AutomatedOlfactoryBehaviour/BEAST/README.md

# BEAST
Supporting material for the manuscript on "High-throughput automated olfactory phenotyping of group-housed mice"
