AutomatedOlfactoryBehaviour/BEAST/Circuit Diagrams/Gear Pump Controller/GearPump2.PDF

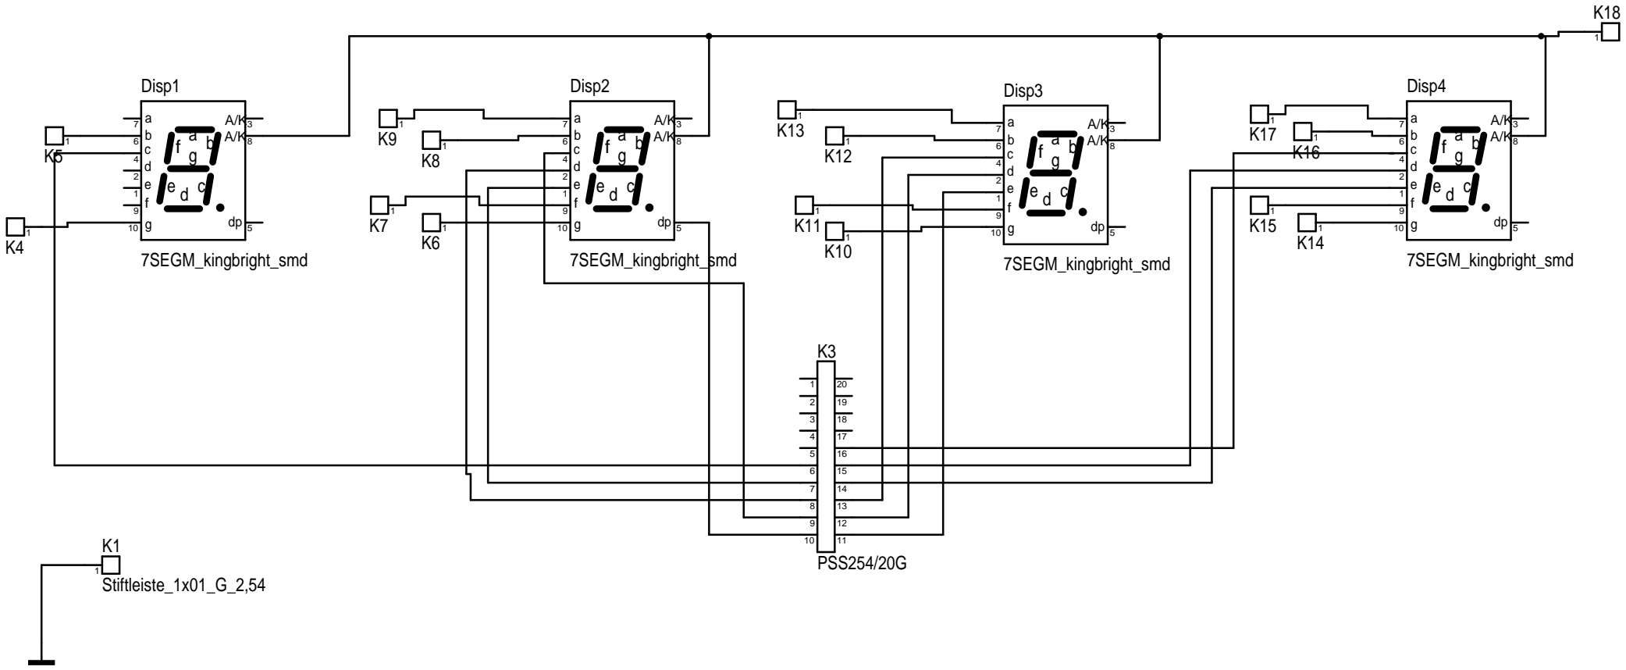
[picture p1: figure]
Stiftleiste_1x01_G_2,54; 7SEGM_kingbright_smd; Disp4; Disp3; PSS254/20G; Disp2; Disp1
