AutomatedOlfactoryBehaviour/BEAST/BillOfMaterials.xlsx

Sheet: README
READ ME
This file contains the main components necessary to construct the automated behaviour setup.
Please refer to the original publication and the accompanying CAD pland for additional information and consumeables.
All parts are grouped by the company from which they were ordered.
The following suppliers were used:
Company Name | Homepage | Comments
Plastic / Metal Parts |  | See CAD plans for detailed list for all needed parts
Asco | https://www.asco.com | Olfactometer valves
EURO ID | http://www.euroid.com/ | RFID Reader System
Festo | https://www.festo.com/ | Tubing, Tube Connectors
First Sensor | https://www.first-sensor.com | Gas Flow Sensors
HNP Mikrosysteme | https://www.hnp-mikrosysteme.de | Water delivery System
MESA Bammental | http://mesa-bammental.de/ | Setup Frame
National Instruments | http://www.ni.com/de-de.html | Data Acquisition Components
Sigmann Elektonik | http://www.sigmann-elektronik.de/ | Lick Sensor, IR Beams & IR Detectors, Power Supply Unit, Gas Flow Regulators
SMC | https://www.smc.eu/ | Tubing, Flowmeters, Air-Filters, Pressure Reducers

Sheet: PlasticMetal Parts
Pos. | Name in CAD Plan | Material | Colour Specifications* | Dimensions (width x height x thickness) | Amount | Comments
1 | HousingCage_Sidepanel_long | Macrolon | clear or transparent-red | 200 mm x 650 mm x 3 mm | 2 | plates covering the housing cage; check relevant local regulations for approved materials for keeping animals
2 | HousingCage_Sidepanel_short | Macrolon | clear or transparent-red | 200 mm x 529.8 mm x 3 mm | 2 | plates covering the housing cage; check relevant local regulations for approved materials for keeping animals
3 | PVC_Floorplate | PVC |  | 644 mm x 660 mm x 8 mm | 4
4 | Pneumatics_Backplane | PVC |  | 589 mm x 730 mm x 10 mm | 1
5 | Mousehotel_Backplane | PVC | clear or transparent-red | 587 mm x 620 mm x 5 mm | 1 | check CAD plan for placement of cutout for the tunnel leading to the odour port
6 | Mousehotel_Frontcover | PVC | clear or transparent-red | 621 mm x 701 mm x 3 mm | 1
7 | Mousehotel_Sidecover | PVC | clear or transparent-red | 661 mm x 734 mm x 3 mm | 2
8 | Mousehotel_Lid | PVC |  | 696 mm x 734 mm x 3mm | 1 | check CAD plan for placement of cutouts for exhaust tubing
* Colour Specifications:
 | If no colour is specified, any colour or transparency grade can be used.
 | Parts covering the housing cage (i.e. parts 1-7) should be made from clear or transparent-red materials to allow experimenters to look inside the housing cage.
 | Parts not in direct contact with animals (i.e. parts 4-7) can be made from clear materials and covered with transparent-red self-adhesive foil to substitute transparent-red PVC.
Pos. | Name in CAD Plan | Material | Type Specifications | Dimensions (width x height x thickness) | Amount | Comments
1 | BeddingStoper | Stainless Steel | plain sheet metal | 607.8 mm x 778 mm x 2 mm | 1 | folded metal sheet; check CAD plan for folding details
2 | BeddingShute | Stainless Steel | plain sheet metal | 800 mm x 1302 mm x 2 mm | 1 | folded metal sheet; check CAD plan for folding details
3 | Tunnel_FloorPlate | Stainless Steel | plain sheet metal | 66.8 mm x 193.4 mm x 2 mm | 1 | folded metal sheet; check CAD plan for folding details
4 | Tunel_GridPlate | Stainless Steel | perforated sheet metal | 80 mm x 300 mm x 2 mm | 1 | hole diameter: 10 mm; folded metal sheet; check CAD plan for folding details
5 | HousingCage_FloorGrid | Stainless Steel | perforated sheet metal | 603 mm x 700 mm x 2 mm | 1 | hole diameter: 10 mm
Pos. | Article | Material | Comments
1 | Exhaust Tubing | PVC; reinforced with PVC spiral | standard garden hose tubing (available from hardware stores); Outer diameter: 32mm; Inner diammeter: 30mm; Recommended: 5-10m

Sheet: Asco
Pos. | Art. Number | Name | Details | Amount | Comments
1 | SC S067A028 | Asco Valves, 2/2 NC, 24VDC | 2/2-Odour Valve; normally closed | 14 | can be reduced to 12 if position 6 is ordered
2 | SC S067A108 | Asco Valves, 3/2 Uni, 24VDC | Air diversion valve | 2
3 | 18801088 | Asco Micro Valves, NC, 24VDC | 3/2-Micro Odour Valve; normally closed | 14 | can be reduced to 12 if position 7 is ordered
4 | 36100040 | Gewinde UNF | Mounting block for SC S067A108 | 2
5 | 88118806 | Connectors | length 0,5m | 30 | one per valve; recommended to order spares
Pos. | Art. Number | Name | Details | Amount | Comments
6 | SC S067A068 | Asco Ventile, 2/2 NO, 24VDC | 2/2-Odour Valve; normally open | 2
7 | 18801098 | Asco Micro10, NO, 24VDC | 3/2-Micro Odour Valve; normally closed | 2

Sheet: EURO ID
Pos. | Art. Number | Name | Amount | Comments
1 | LID-665-Multi | RFID Reader Control Board; running ASCI-protocol (not network-protocol) | 1 | positions 1-4 will be assembled by EURO ID and shipped ready for use
2 | LID-665BP | Control Board Base Plate | 1
3 | CLK-665/650 | Control Board Clock Module | 1
4 | EUR-7005 | Control Board Enclosure | 1
5 | EUR-3120-3m | Microchip Antenna; Diameter: 55mm | 1 | different diameters can be custom made upon request
6 | EUR-5015 | Interface Cable | 1
7 | EUR-12V/850 | RFID Reader Power Supply | 1
8 | ID 100 | RFID Chips; Size: 2,22mm x 12mm | 30 | one per animal; recommended to order more as spares
9 | IID 100 | Microchip Injector | 1
10 | LID 560 | Microchip Handheld Reader | 1

Sheet: Festo
Pos. | Art. Number | Name | Details | Amount | Comments
1 | PUN-6x1-SW | Plastic Tubing PUN | Outer diameter: 6mm; Inner diameter: 4mm; Colour: Black | 1 | one unit equals 50m; can be used interchangeably; different colour only used to aid organisation of tubing
2 | PUN-6x1-BL | Plastic Tubing PUN | Outer diameter: 6mm; Inner diameter: 4mm; Colour: Blue | 1
3 | PUN-4X0,75-BL | Plastic Tubing PUN | Outer diameter: 4mm; Inner diameter: 2,6mm; Colour: Blue | 1 | one unit equals 50m
4 | PUN-8x1,25-SW | Plastic Tubing PUN | Outer diameter: 8mm; Inner diameter: 5,7mm; Colour: Black | 1 | one unit equals 50m
5 | NPFC-X-R14-3G14-MFFF | Kreuzstück | Messing, vernickelt; Außengewinde 1/4; 10 per package | 1 | one unit equals 10 pieces; only 3 pieces needed
6 | CK-1/8-PK-4 | Threaded Fitting | Outer thread: 1/8; Tubing size: 4mm | 1 | one unit equals 10 pieces; only 9 pieces needed
7 | CK-1/4-PK-4 | Threaded Fitting | Outer thread: 1/4; Tubing size: 4mm | 1 | one unit equals 10 pieces; only 9 pieces needed
8 | LCKN-1/8-PK-4 | Threaded L-fitting | Outer thread: 1/8; Tubing size: 4mm | 2 | one unit equals 10 pieces; 14 ieces needed
9 | LCKN-1/4-PK-4 | Threaded L-fitting | Outer thread: 1/4; Tubing size: 4mm | 1 | one unit equals 10 pieces; 3 pieces needed
10 | NPFC-Y-3G14-F | Threaded Y-fitting | Inner thread: 1/4 | 2 | one unit equals 10 pieces; only one piece needed
11 | QS-8-6 | Push-In Fitting | Tube to Tube Connectors; Outer diameter tube 1: 8mm; Outer diameter Tube 2: 6mm | 1 | one unit equals 10 pieces; only 1 piece needed
12 | QS-6-4 | Push-In Fitting | Tube to Tube Connectors; Outer diameter tube 1: 6mm; Outer diameter Tube 2: 4mm | 1 | one unit equals 10 pieces; only 9 pieces needed
13 | QSY-4 | Push-In Fitting | all tubes outer diameter 4mm | 1 | one unit equals 10 pieces; only 1 piece needed

Sheet: First Sensor
Pos. | Art. Number | Name | Details | Amount | Comments
1 | WTAL005DUP | Flow Sensor | 5V@5slpm | 2 | setup images show 3 but 2 are sufficient
2 | WTAL010DUP | Flow Sensor | 5V@10slpm | 1 | measures exhaust flow
3 | WBAM200DuHo | Mass Flow Sensors | 5V@200sccm | 2 | measures flow to outer olfactometer channels

Sheet: HNP Mikrosysteme
Pos. | Art. Number | Name | Details | Amount | Comments
1 | 11010103 | Micro Annular Gear Pump | Type MRZ-2521 | 1
2 | 66020101 | Gear Pump Control Board | Type S-ND | 1
3 | 41030100 | Check Valve RSV-UP-210 | PEEK; Inlet: 1/4''-28 UNF; Outlet: 1/4''-28 UNF | 1
4 | 54020101 | Filter | Type: F-UP2; AD 1/8"; Pore Size: 10µm; Material: EFTE | 1
5 | 51010202 | Pipe Fitting | PEEK; Size: 1/4"-28 UNF | 1
6 | 52020302 | Fluid Adapter | PEEK; Connector 1: 1/4"-28 UNF; Connector 2: Luer-Lock male | 1
7 | 58010906 | Dosing Nozzle | Inner diameter: 0,16mm | 1 | recommended to order more as spares
8 | 92000935 | Extension Cable | Length: 1,5m | 1
9 | 55020200 | Tubing | Length: 1m; Outer diameter: 1/8''; Inner diameter: 1/6'' | 1

Sheet: Mesa Bammental
Pos. | Art. Number | Name | Details | Amount | Comments
1 | 1.11.040040.43S-AA4AA4/1360 | Profile 40, 4E, S, 1360mm | Width bars (4x Edges & 4 supports for middle and upper compartment) | 8 | All profiles should be saw cut to the lenhths specifiec and should be ordered with cross bushing bores at both ends. The length of the profiles and the type of bores are already specified by the respective appendix (AA4AA4/length).
2 | 1.11.040040.43S-AA4AA4/1627 | Profile 40, 4E, S, 1627mm | Vertical Bars (4x edges) | 4
3 | 1.11.040040.43S-AA4AA4/200 | Profile 40, 4E, S, 200mm | 4x Mousehotel (height bars) | 4
4 | 1.11.040040.43S-AA4AA4/330 | Profile 40, 4E, S, 330mm | vertical bars (4x middle compartment) | 4
5 | 1.11.040040.43S-AA4AA4/529,8 | Profile 40, 4E, S, 529,8mm | 2x drawer depth bars & 4x mousehotel depth bar | 6
6 | 1.11.040040.43S-AA4AA4/550 | Profile 40, 4E, S, 550mm | 2x vertical bars (bottom compartment) | 2
7 | 1.11.040040.43S-AA4AA4/620 | Profile 40, 4E, S, 620mm | Depth bars (4x corners & 6x support for middle and upper compartment & 2x in middle of floor & lid) | 11
8 | 1.11.040040.43S-AA4AA4/587 | Profile 40, 4E, S, 587mm | vertical bars (upper compartment) | 2
9 | 1.11.040040.43S-AA4AA4/660 | Profile 40, 4E, S, 660mm | 2x mousehotel (width support bars) & 2x width bars for drawer (support for drawer wheels) | 4
10 | 1.11.040040.43S-AA4AA4/700 | Profile 40, 4E, S, 700mm | 4x mousehotel (width bars; 2xbottom + 2x top) | 4
11 | 1.11.040040.43S-AA4AA4/950 | Profile 40, 4E, S, 950mm | 2x drawer (width bars) | 2
12 | 1.45.80200.073 | Locking castors | Wheels underneath setup | 4 | Use bigger diameter wheels if setup will be moved often
13 | 1.67.42E3M8 | slot roller E3; M8 | Slot rollers for drawer | 12 | more rollers can be used if desired
14 | 1.32.4EM8 | T-nut for insertion into E-profile with spring; M8 | for fixing the slot rollers into the profiles | 12 | same amount as rollers
15 | 1.32.4EM6 | T-nut for insertion into E-profile with spring; M6 | for fixing anything into the profiles | ≈150 | approximate amount
16 | 1.47.225160.2 | Floor mounting plate | Corner Pieces to stabilize floor plates | 5 | more can be used if desired
17 | 1.21.4E0E | Ground connector / Universal connector | Connection of any alu profile | ≈100 | approximate amount
18 | 1.64.153030.2.99 | Mounting block GD-Zn | i.e. as fasteners for PVC plates | ≈80 | extremely usefull for fixing anything to the profiles; recommended to order more
19 | 1.65.2101 | Magnetic lock | closing mechnanism for doors | 5
20 | 1.62.842032085 | Alu hinges | holds door covers in place | 6
21 | 1.19.19040-A00A00/329 | 19"-Profile, cut to 329mm | holds power supply in place | 2
22 | 1.72.2010.10 | Mounting set for 19"-Profiles | Attachments for 19'' profiles | 1 | 1 packaging unit equals 10 pieces; 10 pieces needed
23 | 0.63.D00912.06016 | Cap-screw, DIN 912 - M6x16 | screws corresponding to M6 T-nuts | ≈100 | approximate amount; potentially add more/different length ones
24 | 1.42.20404.2 | Cover Cap 40x40, black | cover for blunt bar ends | 8 | recommended to prevent dirt collection; order more as spares
25 | 1.42.504.2 | Cover plugs 40, black | Covers for universal connectors | 100 | recommended to prevent dirt collection; order more as spares
26 | 1.41.E346.2 | Combination Profiles E 4,5-6; black | Cover of open profiles & to fix PVC plates | 5 | highly recommended to prevent dirt collection inside profiles; order more as spares

Sheet: National Instruments
Pos. | Art. Number | Name | Details | Amount | Comments
1 | NI BNC-2090A | 779556-01 | Data Acquisition and BNC Connector Block | 2
2 | NI PCI-6229 | 779068-01 | PCI I/O Device | 2 | one per computer
3 | NI SHC68-68-EMP | 192061-02 | connector cable for PCI-6229 | 3

Sheet: Sigmann Elektronik
Pos. | Art. Number | Name | Details | Amount | Comments
1 | 3000750 | NIM-Bin with Power | Main Power Supply | 1
2 | 3000701 | Main Gas Flow Regulator |  | 1 | provides air supply to central manifold of olfactometer
3 | 3000794 | Gas Flow Regulators |  | 2 | provides air supply to outer olfactometer channels
4 | 3001048 | Darlington Sensor | Licksensor | 1
5 | 3001049 | Darlington Power Supply | Power Supply for Lick Sensor | 1
6 | 3001046 | IR Beam Detector |  | 1 | capable of integrating up to 12 IR Beams
7 | 3001047 | IR Beam LEDs with cable connectors |  | 2 | recommended to order more as spares

Sheet: SMC
Pos. | Art. Number | Name | Amount | Comments
1 | AMH250C-F02D | Micro Mist Separator | 1
2 | AMH250C-F02B | Micro Mist Separator | 1
3 | AME250C-F02B | Supermicrofilter | 1
4 | Y300T-A | interface with bracket for air filters | 2
5 | PFM710S-F01-E | Air Flowmeter | 2 | setup pictures show 3 but 2 are sufficient
6 | IR2000-F02 | Precision Pressure Regulator 1/8; Supply & out port 1/4 | 4
7 | P36202028 | Bracket for IR2000-F02 | 4
8 | ISE30A-01-B-ML | Digital Pressure Gauge | 4
9 | TIUB01C-20 | Odour Tubing; inner diameter: 3,18mm | ≈20 metres | colour not critical; recommended to buy larger quantity as this will be replaced continuously
10 | KQ2S23-M5N | Push-Fitting for odour tubing; Tubing diameter: 3,2mm; Thread size: M5 | 4 | packaging unit equals 10 pieces; 41 pieces are needed for an olfactometer with 9 odour valves per channel
11 | KQ2S04-M5N | Push-Fitting for tubing; Tubing diameter: 4mm; Thread size: M5 | 1 | packaging unit equals 10 pieces; 4 pieces are needed
12 | VK3120-5D-M5 | Final Valve with DIN-type connector; Thread sizes: M5 | 1
