AutomatedOlfactoryBehaviour/BEAST/3D Printing Files/FanAdapters/FanAdapter.stl

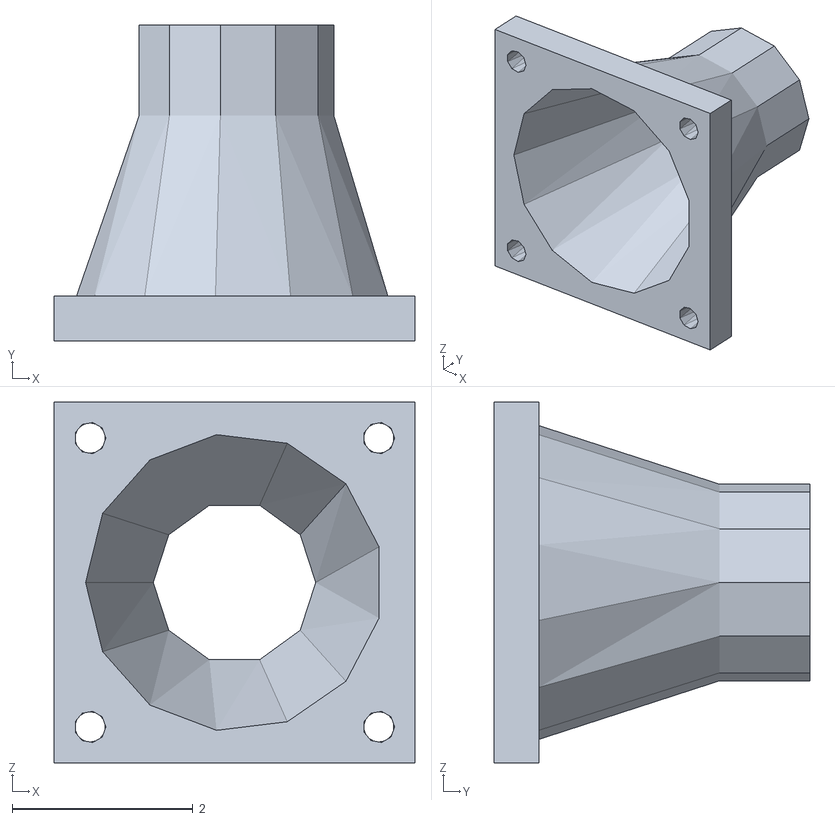
[picture p2: CAD file, 2019-04-17]
3D Printing Files/FanAdapters/FanAdapter.stl
4.00 x 3.50 x 4.00
