AutomatedOlfactoryBehaviour/BEAST/3D Printing Files/TubingAdapters/PipeAdapter.stl

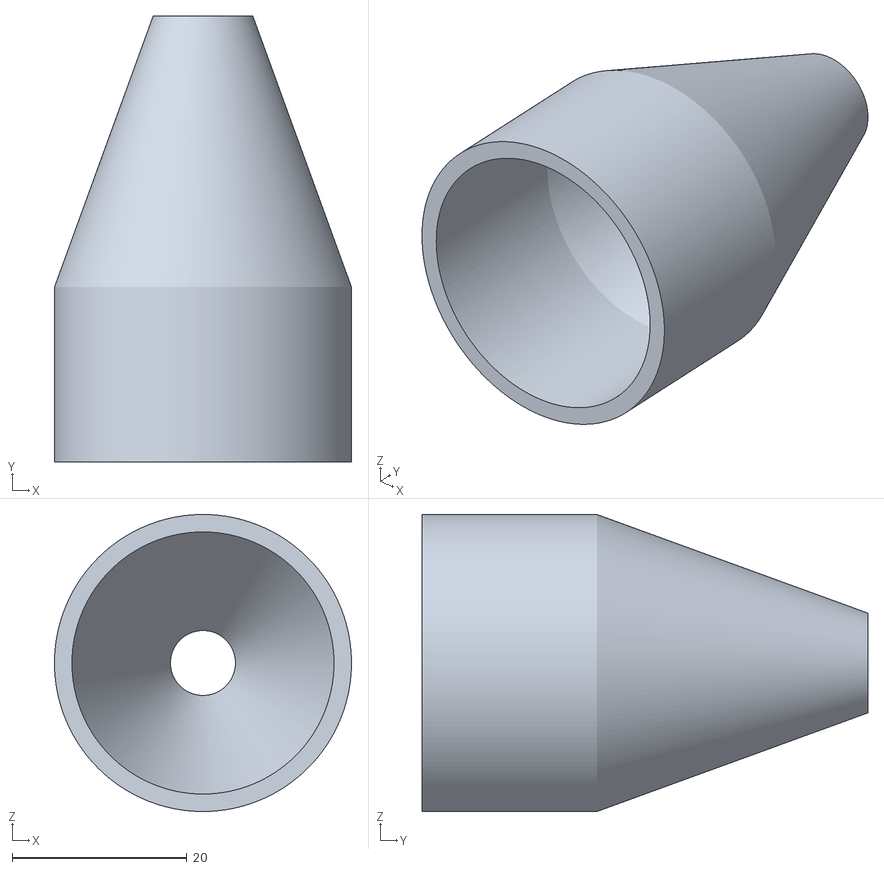
[picture p3: CAD file, 2019-04-17]
3D Printing Files/TubingAdapters/PipeAdapter.stl
34.0 x 51.0 x 34.0
