AutomatedOlfactoryBehaviour/BEAST/3D Printing Files/TunelHolder/TunelHolder.stl

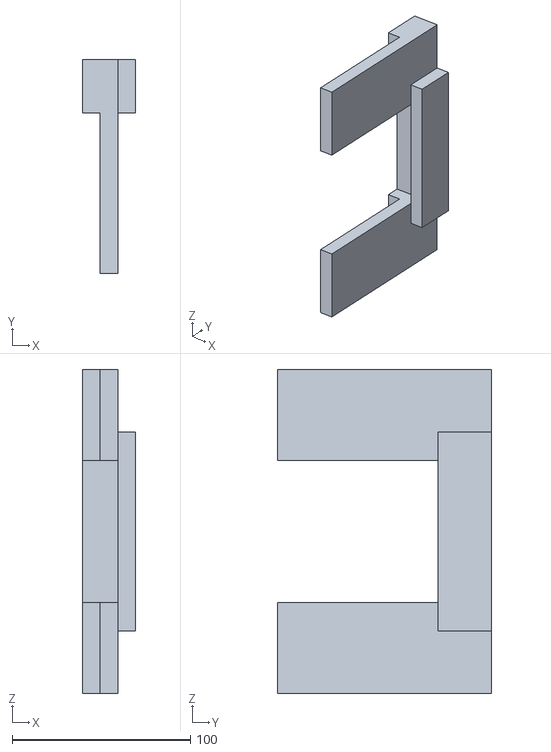
[picture p4: CAD file, 2019-04-17]
3D Printing Files/TunelHolder/TunelHolder.stl
30.0 x 120.0 x 182.0
