AutomatedOlfactoryBehaviour/BEAST/3D Printing Files/WaterPumpHolder/WaterPumpHolder.stl

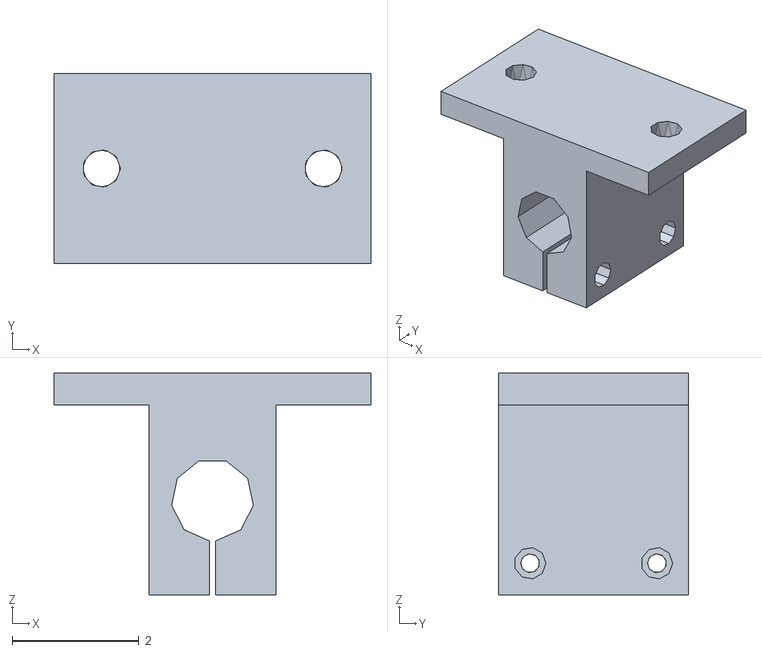
[picture p5: CAD file, 2019-04-17]
3D Printing Files/WaterPumpHolder/WaterPumpHolder.stl
5.00 x 3.00 x 3.50
