AutomatedOlfactoryBehaviour/BEAST/3D Printing Files/TubingAdapters/TubingHolder.stl

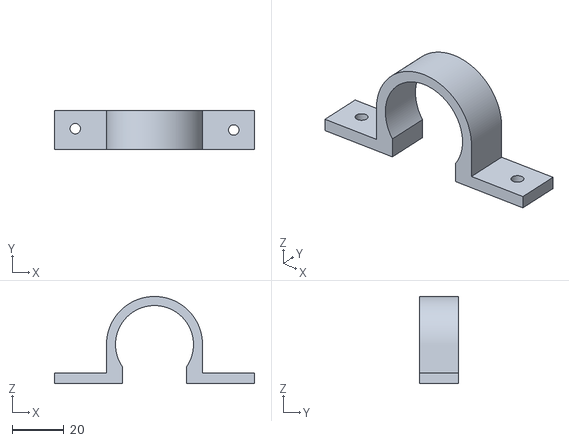
[picture p6: CAD file, 2019-04-17]
3D Printing Files/TubingAdapters/TubingHolder.stl
77.0 x 15.0 x 33.5
