AutomatedOlfactoryBehaviour/BEAST/3D Printing Files/TubingAdapters/ThreePipeAdapter.stl

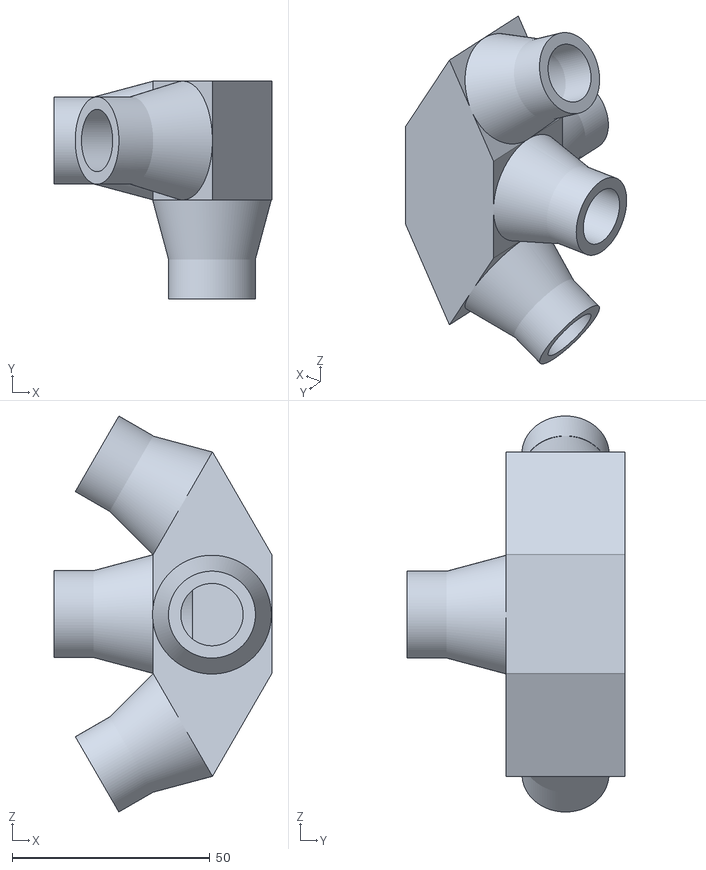
[picture p7: CAD file, 2019-04-17]
3D Printing Files/TubingAdapters/ThreePipeAdapter.stl
55.0 x 55.0 x 100.0
