AutomatedOlfactoryBehaviour/BEAST/(list of files, cad)

Other CAD files:
3D Printing Files/FanAdapters/FanAdapter.ipt
3D Printing Files/TubingAdapters/PipeAdapter.ipt
3D Printing Files/TubingAdapters/ThreePipeAdapter.ipt
3D Printing Files/TubingAdapters/TubingHolder.ipt
3D Printing Files/TunelHolder/TunelHolder.ipt
3D Printing Files/WaterPumpHolder/WaterPumpHolder.ipt
CAD Files/CageLid&Tunel/CageLid&Tunnel.iam
CAD Files/CageLid&Tunel/FoodHopperLid.ipt
CAD Files/CageLid&Tunel/Lid_FrontPanel.ipt
CAD Files/CageLid&Tunel/Lid_Inlet.ipt
CAD Files/CageLid&Tunel/Lid_Inlet2.ipt
CAD Files/CageLid&Tunel/Lid_MaintenanceCover.ipt
CAD Files/CageLid&Tunel/Lid_SidePanel.ipt
CAD Files/CageLid&Tunel/Lid_TopPanel.ipt
CAD Files/CageLid&Tunel/Lid_TopPanel2.ipt
CAD Files/CageLid&Tunel/OldVersions/CageLid&Tunnel.0041.iam
CAD Files/CageLid&Tunel/OldVersions/Lid_Inlet.0003.ipt
CAD Files/CageLid&Tunel/Scale.ipt
CAD Files/CageLid&Tunel/ScaleCompartment_FloorPlate.ipt
CAD Files/CageLid&Tunel/ScaleCompartment_SidePanel.ipt
CAD Files/CageLid&Tunel/Tunel_BackCoverToOdourPort.ipt
CAD Files/CageLid&Tunel/Tunel_Door.ipt
CAD Files/CageLid&Tunel/Tunel_FloorPlate.ipt
CAD Files/CageLid&Tunel/Tunel_FrontPanel.ipt
CAD Files/CageLid&Tunel/Tunel_GridPlate.ipt
CAD Files/CageLid&Tunel/Tunel_IRBeam.ipt
CAD Files/CageLid&Tunel/Tunel_IRBeamHolder.ipt
CAD Files/CageLid&Tunel/Tunel_LidWithFanHoles.ipt
CAD Files/CageLid&Tunel/Tunel_Motor.ipt
CAD Files/CageLid&Tunel/Tunel_OdourPortSlidingMechanism.ipt
CAD Files/CageLid&Tunel/Tunel_SidePanel.ipt
CAD Files/CageLid&Tunel/Tunel_SidePanel2.ipt
CAD Files/CageLid&Tunel/Tunnel_Holder.ipt
CAD Files/OdourPort/AssembledOdourPort.iam
CAD Files/OdourPort/OdourPort_Backplate.ipt
CAD Files/OdourPort/OdourPort_MainBody.ipt
CAD Files/Olfactometer/2027 CK-1_8-PK-4.ipt
CAD Files/Olfactometer/Assembled_Olfactometer.iam
CAD Files/Olfactometer/CentralManifold.ipt
CAD Files/Olfactometer/KQ2S23_M5N_N.ipt
CAD Files/Olfactometer/Olfactometer_Holder.ipt
CAD Files/Olfactometer/OuterOlfactometerChannel.ipt
CAD Files/Olfactometer/Valve_Inside.ipt
CAD Files/Olfactometer/Valve_Outside.ipt
CAD Files/SetupFrame/BeddingShute.ipt
CAD Files/SetupFrame/BeddingStopper.ipt
CAD Files/SetupFrame/Boden2.ipt
CAD Files/SetupFrame/Frame_KunerLab.iam
CAD Files/SetupFrame/HousingCage_FloorGrid.ipt
CAD Files/SetupFrame/HousingCage_Sidepanel_long.ipt
CAD Files/SetupFrame/HousingCage_Sidepanel_short.ipt
CAD Files/SetupFrame/May Tec 1_47_225160_2_Floor mounting plate_schwarz-Pulverbeschichtet.ipt
CAD Files/SetupFrame/May Tec 1_64_153030_2_Mounting blocks GD-Zn_schwarz 0.ipt
CAD Files/SetupFrame/May Tec 1_65_2101_Magnetic lock PA 0.ipt
CAD Files/SetupFrame/May Tec 1_71_30365_Installation ring_36_5.ipt
CAD Files/SetupFrame/MayTec 1_11_040040_43S_Profile 40x40, 4E, S_100_Detail_(0;0,0,0).ipt
CAD Files/SetupFrame/MayTec 1_11_040040_43S_Profile 40x40, 4E, S_1360_Detail_(0;0,0,0).ipt
CAD Files/SetupFrame/MayTec 1_11_040040_43S_Profile 40x40, 4E, S_1627_Detail_(0;0,0,0).ipt
CAD Files/SetupFrame/MayTec 1_11_040040_43S_Profile 40x40, 4E, S_200_Detail_(0;0,0,0).ipt
CAD Files/SetupFrame/MayTec 1_11_040040_43S_Profile 40x40, 4E, S_330_Detail_(0;0,0,0).ipt
CAD Files/SetupFrame/MayTec 1_11_040040_43S_Profile 40x40, 4E, S_529_8_Detail_(0;0,0,0).ipt
CAD Files/SetupFrame/MayTec 1_11_040040_43S_Profile 40x40, 4E, S_545_Detail_(0;0,0,0).ipt
CAD Files/SetupFrame/MayTec 1_11_040040_43S_Profile 40x40, 4E, S_550_Detail_(0;0,0,0).ipt
CAD Files/SetupFrame/MayTec 1_11_040040_43S_Profile 40x40, 4E, S_560_Detail_(0;0,0,0).ipt
CAD Files/SetupFrame/MayTec 1_11_040040_43S_Profile 40x40, 4E, S_572_Detail_(0;0,0,0).ipt
CAD Files/SetupFrame/MayTec 1_11_040040_43S_Profile 40x40, 4E, S_609_8_Detail_(0;0,0,0).ipt
CAD Files/SetupFrame/MayTec 1_11_040040_43S_Profile 40x40, 4E, S_620_Detail_(0;0,0,0).ipt
CAD Files/SetupFrame/MayTec 1_11_040040_43S_Profile 40x40, 4E, S_627_Detail_(0;0,0,0).ipt
CAD Files/SetupFrame/MayTec 1_11_040040_43S_Profile 40x40, 4E, S_628_Detail_(0;0,0,0).ipt
CAD Files/SetupFrame/MayTec 1_11_040040_43S_Profile 40x40, 4E, S_660_Detail_(0;0,0,0).ipt
CAD Files/SetupFrame/MayTec 1_11_040040_43S_Profile 40x40, 4E, S_700_Detail_(0;0,0,0).ipt
CAD Files/SetupFrame/MayTec 1_11_040040_43S_Profile 40x40, 4E, S_950_Detail_(0;0,0,0).ipt
CAD Files/SetupFrame/MayTec 1_19_19040_19 inch special profile, PG 40_329.ipt
CAD Files/SetupFrame/MayTec 1_45_80200_073_Locking castor 200kg, with plate - Kopie.ipt
CAD Files/SetupFrame/MayTec 1_45_80200_073_Locking castor 200kg, with plate.ipt
CAD Files/SetupFrame/MayTec 1_46_20639_Angle Alu 60x60, D9_0, B30.ipt
