AutomatedOlfactoryBehaviour/BEAST/Circuit Diagrams/Gear Pump Controller/GearPump3.PDF

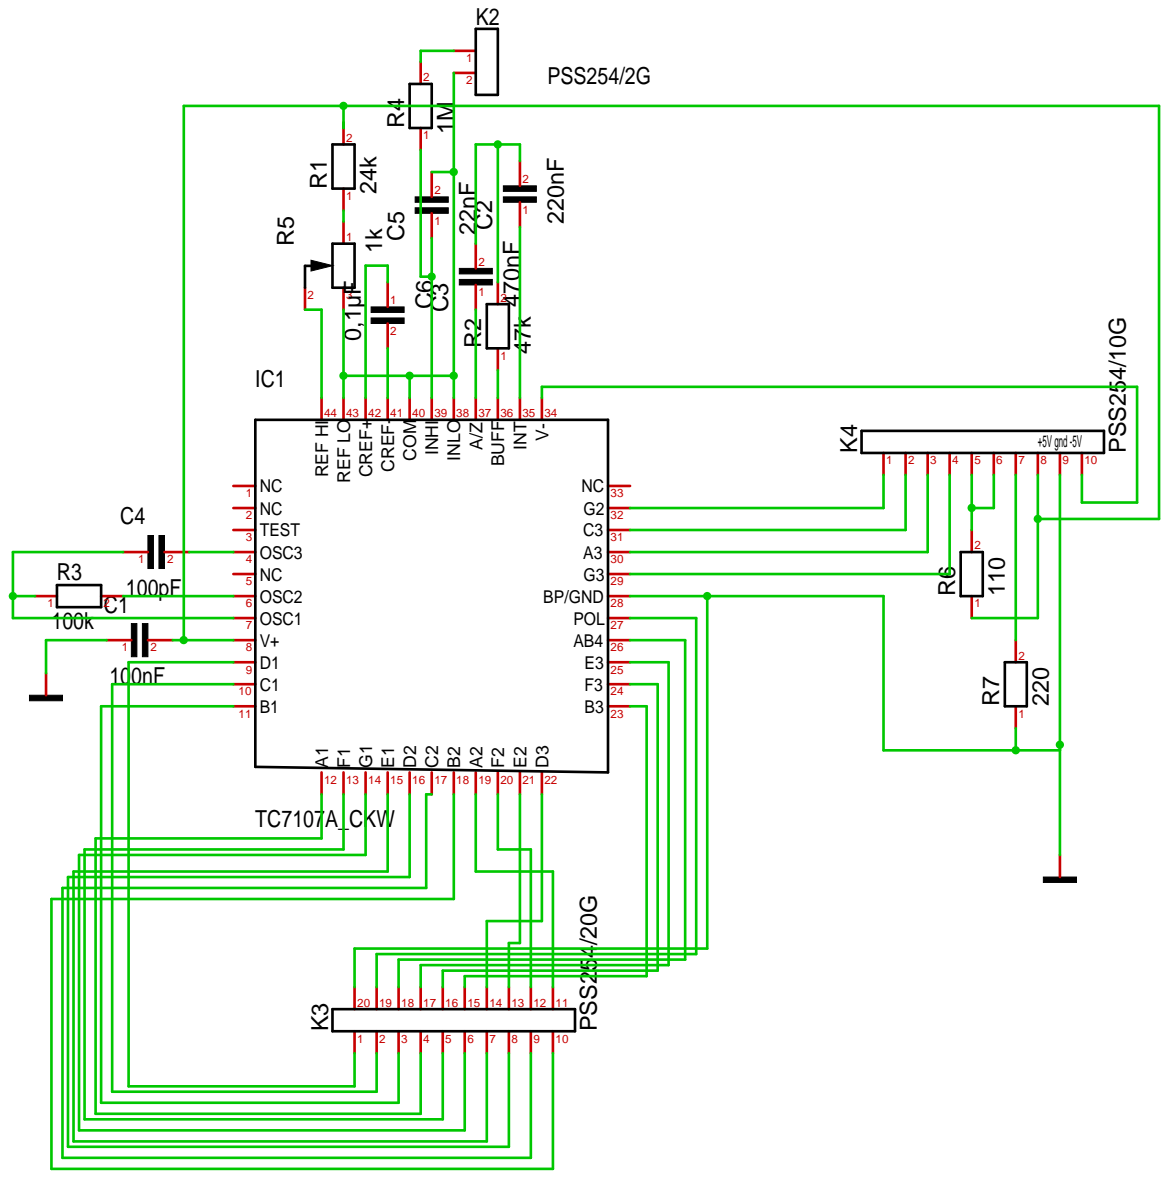
[picture p12: page 1]
