AutomatedOlfactoryBehaviour/BEAST/Circuit Diagrams/Valve Controller/AdapterForULN2803_SCH.PDF

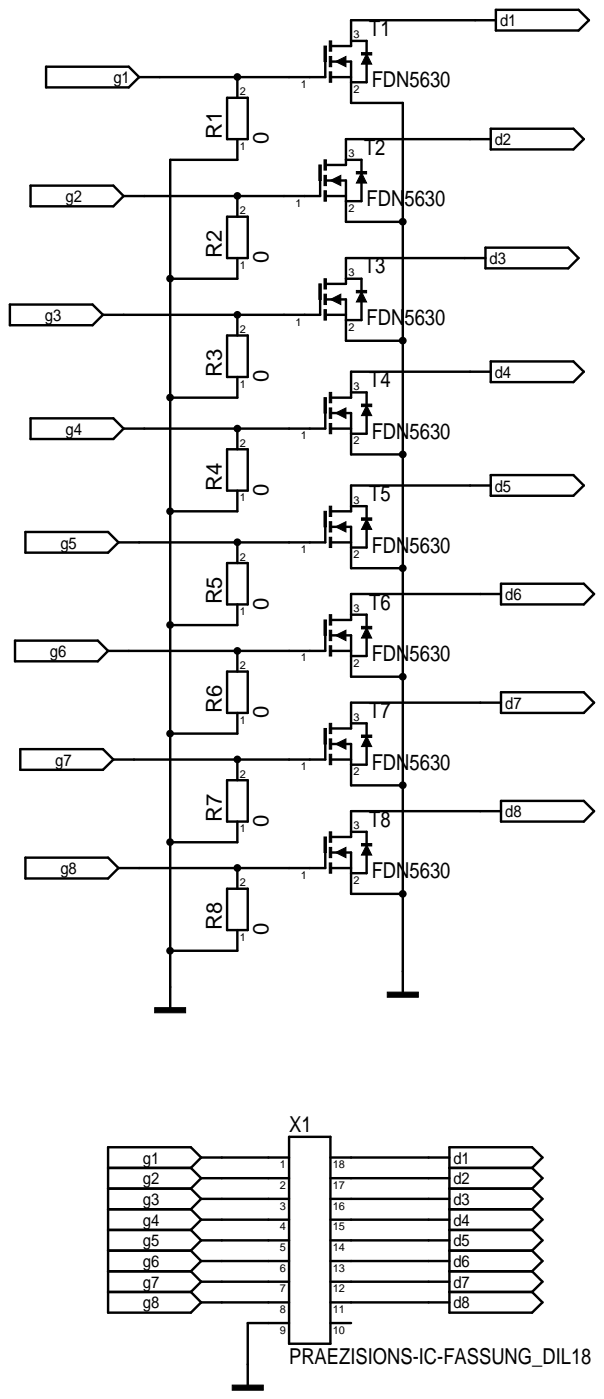
[picture p13: page 1]
