AutomatedOlfactoryBehaviour/BEAST/Circuit Diagrams/Gear Pump Controller/GearPump1.PDF

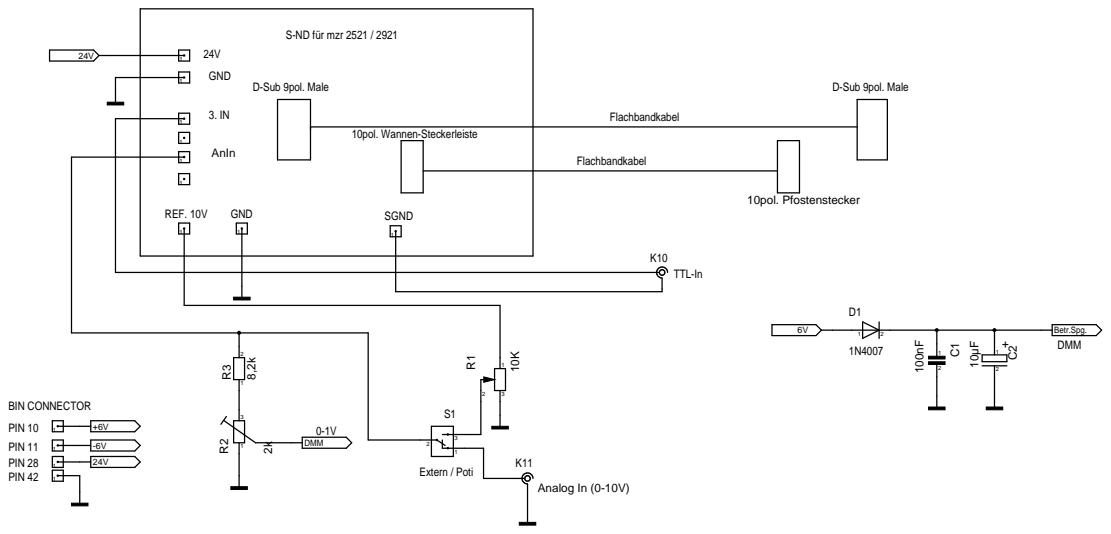
[picture p8: page 1]
PIN 11; 10pol. Pfostenstecker; D-Sub 9pol. Male; Flachbandkabel; DMM; AnIn; GND; PIN 42; PIN 28; PIN 10; BIN CONNECTOR; 10pol. Wannen-Steckerleiste; REF. 10V; SGND; Betr.Spg.; Analog In (0-10V); TTL-In; Extern / Poti

S-ND für mzr 2521 / 2921
