AutomatedOlfactoryBehaviour/BEAST/Circuit Diagrams/Rotary Magnet Controller/RotayMagnetController.PDF

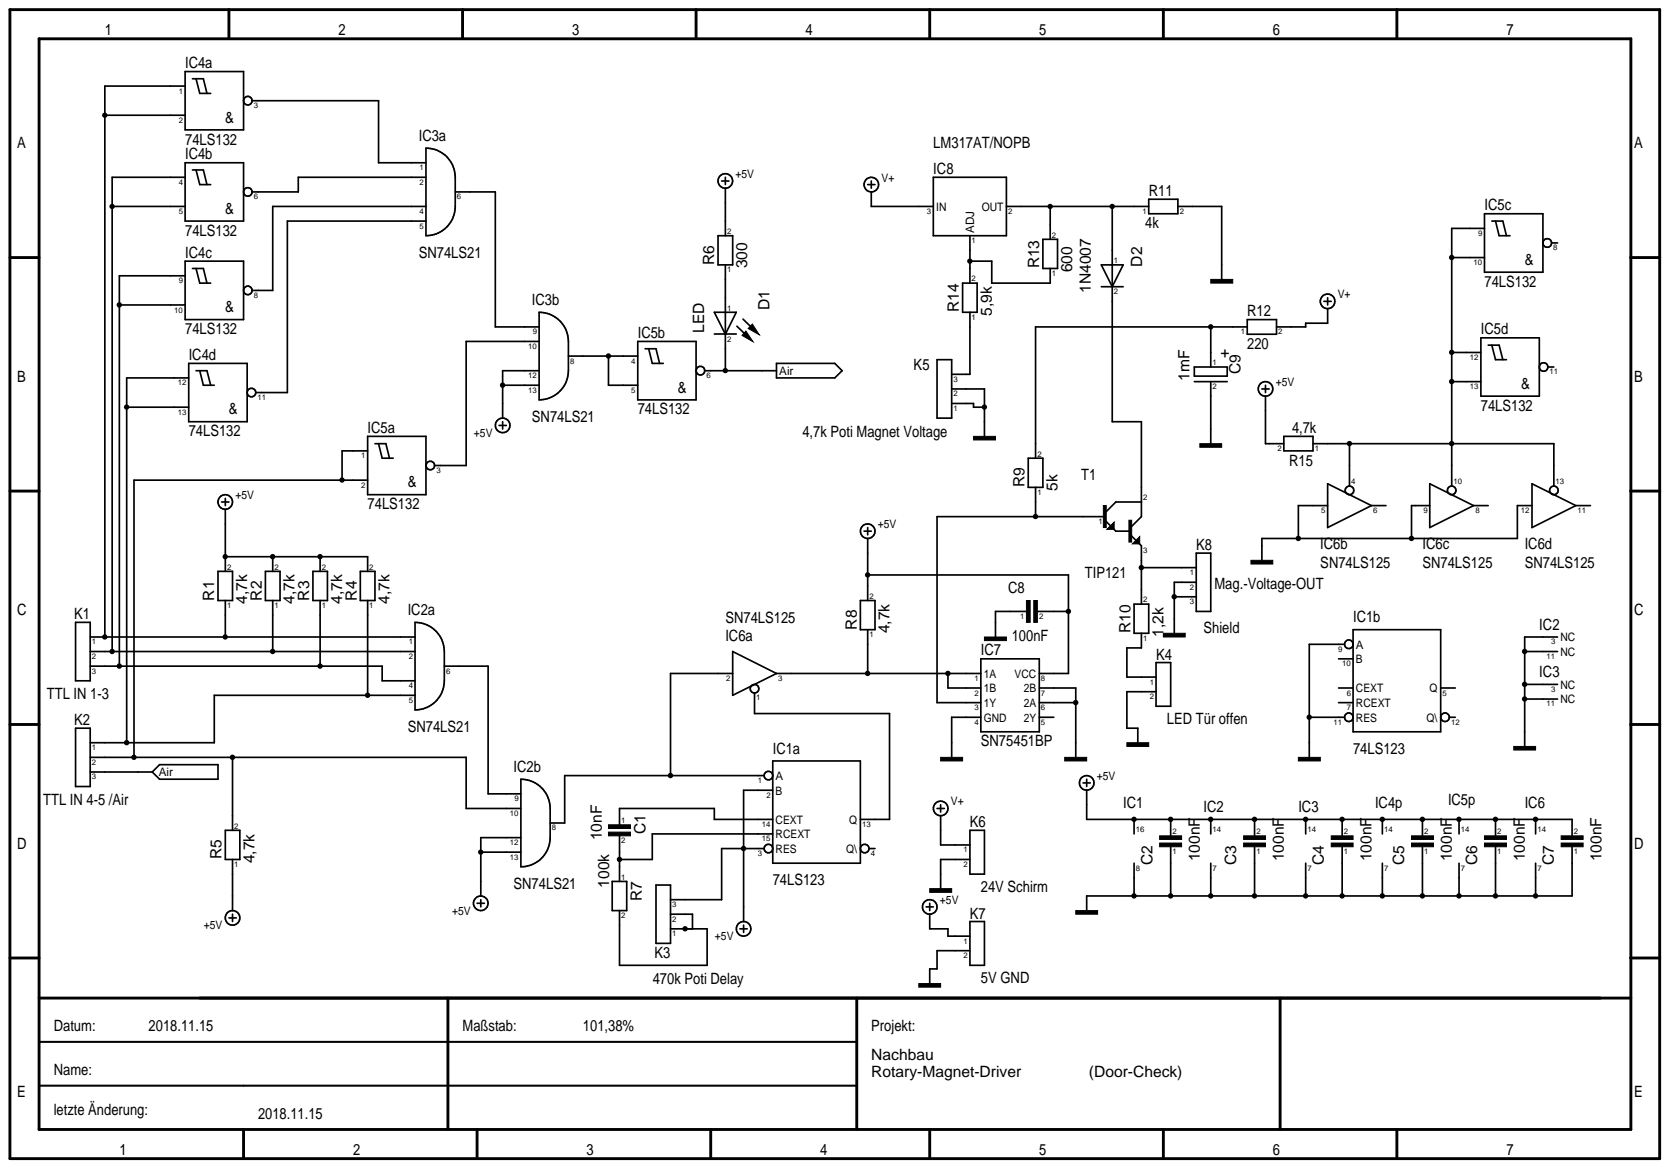
[picture p9: page 1]

Datum: 2018.11.15 | Maßstab: 101,38% | Projekt: Nachbau Rotary-Magnet-Driver (Door-Check)

Name:

letzte Änderung: 2018.11.15
