AutomatedOlfactoryBehaviour/BEAST/Circuit Diagrams/Valve Controller/AdapterForNationalInstrumentsPCIcards.PDF

5 GND | X4 4 GND | X4 ³ GND | X4

X4

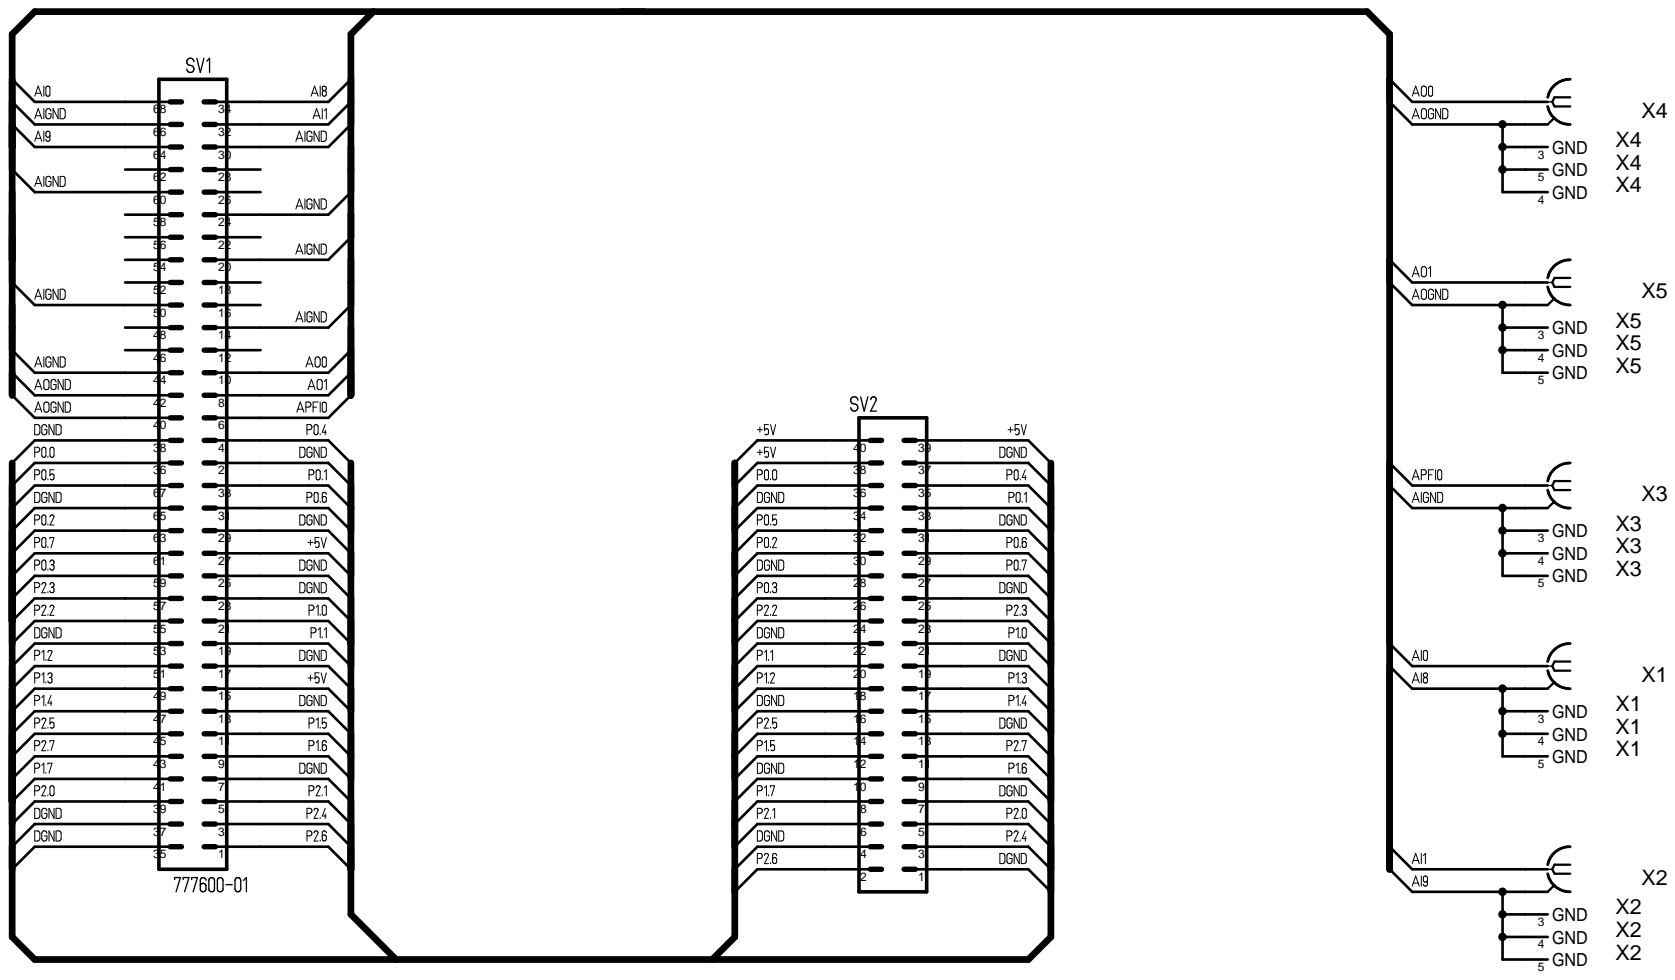
[picture p10: page 1]
5 GND; X1 ⁴ GND; X1 ³ GND; X2 ⁴ GND; X2 ³ GND; X3 ⁴ GND; X3 ³ GND; X5 ⁴ GND; X5 ³ GND
