AutomatedOlfactoryBehaviour/BEAST/Circuit Diagrams/Valve Controller/ConnectorBetweenAdaptorAndOutput.PDF

9 | GND | 10 7654321 | 18

IC1

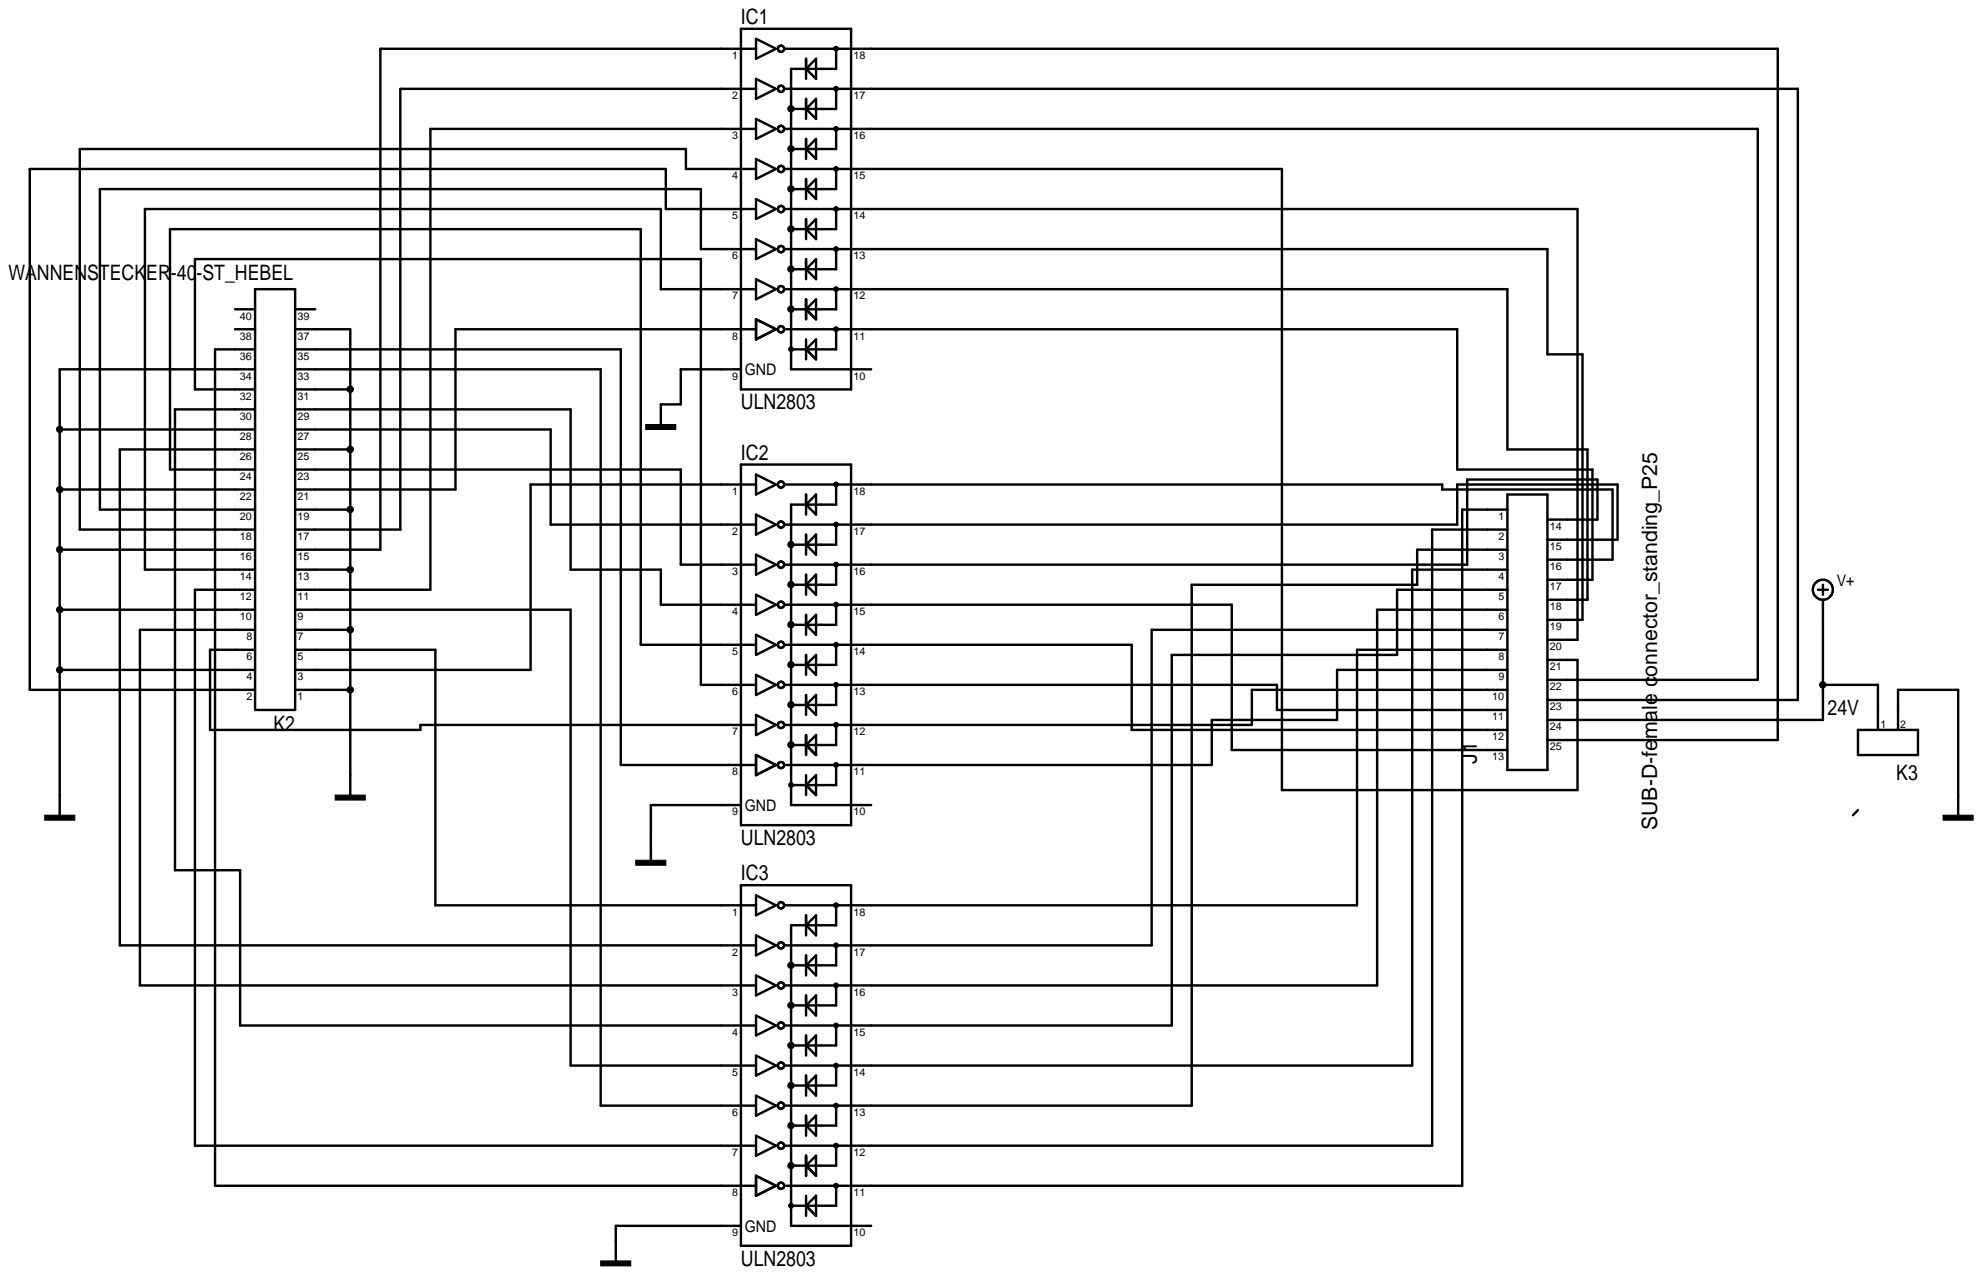
[picture p11: page 1]
SUB-D-female connector_standing_P25; GND; ULN2803; WANNENSTECKER-40-ST_HEBEL
