AutomatedOlfactoryBehaviour/BEAST/Circuit Diagrams/Gear Pump Controller/GearPump3.PDF

# PSS254/2G

K2
